yosemate/SpectrumLabPro-NIR-Kappa/docs/diagramas/amostras_ensaio_bancada.png

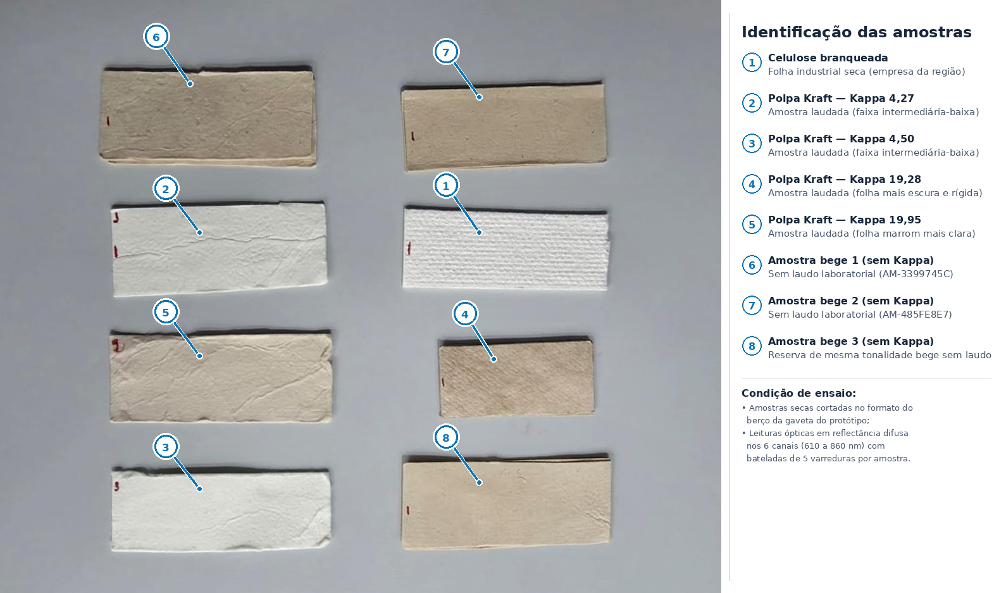
docs/diagramas/amostras_ensaio_bancada.png
