yosemate/SpectrumLabPro-NIR-Kappa/supervisorio/experiments/chemometrics/samples.csv

sample_id | position_id | reference_status | kappa | mode | source | r610 | r680 | r730 | r760 | r810 | r860
Celulose Branqueada | 1 | assumed | 0.58 | seco | Historico_Ensaios_20261104_134937.csv#AM-59970EEA | 0.895083515410534 | 0.8657941383580604 | 0.8793514544587505 | 0.8887390424814566 | 0.9374505146476644 | 0.8955890563930765
K4.27 | 1 | laboratory | 4.27 | seco | Historico_Ensaios_20261104_134937.csv#AM-E135CCEB | 0.9015022369484662 | 0.8992545467790107 | 0.8682244476235891 | 0.8808399961468067 | 0.9191267956113562 | 0.9262981574539364
K4.50 | 1 | laboratory | 4.5 | seco | Historico_Ensaios_20261104_134937.csv#AM-C46E7D0C | 0.7731278061898245 | 0.7919772721754121 | 0.7725321888412018 | 0.7742992004623832 | 0.7867888247935754 | 0.7995533221663874
K19.95 | 1 | laboratory | 19.95 | seco | Historico_Ensaios_20261104_134937.csv#AM-02C19AFC | 0.5799739089373894 | 0.6331253186994633 | 0.6561754887935146 | 0.6535015894422503 | 0.6123741658183462 | 0.6186487995533222
K19.28 | 1 | laboratory | 19.28 | seco | Historico_Ensaios_20261104_134937.csv#AM-88B14C31 | 0.39730445708980605 | 0.4741276740402593 | 0.48778678535473957 | 0.4876216164146036 | 0.43931681936432526 | 0.45728643216080406
K19.28 | 2 | laboratory | 19.28 | seco | AmostraKappa19.28Leitura2.pdf#AM-CECEA30A (PDF percent rounded to 0.01) | 0.4617 | 0.5431 | 0.5592 | 0.5593 | 0.5065 | 0.5254
K19.28 | 3 | laboratory | 19.28 | seco | AmostraKappa19.28Leitura3.pdf#AM-1658F269 (PDF percent rounded to 0.01) | 0.3367 | 0.3725 | 0.3829 | 0.3836 | 0.3751 | 0.38189999999999996
