yosemate/SpectrumLabPro-NIR-Kappa/supervisorio/experiments/chemometrics/samples_2sessoes_20261104.csv

sample_id | position_id | reference_status | kappa | mode | source | r610 | r680 | r730 | r760 | r810 | r860
Celulose Branqueada | cal1_pos1 | assumed | 0.58 | seco | Historico_Ensaios.csv#2 (13:29) | 0.895083515410534 | 0.8657941383580604 | 0.8793514544587505 | 0.8887390424814566 | 0.9374505146476644 | 0.8955890563930765
Celulose Branqueada | cal2_pos1 | assumed | 0.58 | seco | amostrabranqueada.json#AM-2372B3D5 (15:42) | 0.9197962871693774 | 0.8533909244365009 | 0.9187376292060699 | 0.8803196803196803 | 0.896184971098266 | 0.8724794092587332
K4.27 | cal1_pos1 | laboratory | 4.27 | seco | Historico_Ensaios.csv#5 (13:40) | 0.9015022369484662 | 0.8992545467790107 | 0.8682244476235891 | 0.8808399961468067 | 0.9191267956113562 | 0.9262981574539364
K4.27 | cal2_pos1 | laboratory | 4.27 | seco | amostra4.27.json#AM-16186A6A (15:32) | 0.9423196977164449 | 0.9504021447721179 | 0.9142291620848911 | 0.9300699300699301 | 0.9632369942196533 | 0.9775631922749218
K4.50 | cal1_pos1 | laboratory | 4.5 | seco | Historico_Ensaios.csv#4 (13:37) | 0.7731278061898245 | 0.7919772721754121 | 0.7725321888412018 | 0.7742992004623832 | 0.7867888247935754 | 0.7995533221663874
K4.50 | cal2_rep1 | laboratory | 4.5 | seco | Historico_Ensaios.csv#12 (15:23) | 0.8328733366190241 | 0.858107437195909 | 0.848031669232461 | 0.8659340659340659 | 0.8411560693641619 | 0.8588469184890654
K4.50 | cal2_rep2 | laboratory | 4.5 | seco | comparewacao_pls.json#AM-2EE02E57 (15:26) | 0.8323969114506325 | 0.8561711845894151 | 0.8478117440070376 | 0.8621378621378621 | 0.8397687861271677 | 0.8588469184890655
K19.95 | cal1_pos1 | laboratory | 19.95 | seco | Historico_Ensaios.csv#7 (13:46) | 0.5799739089373894 | 0.6331253186994633 | 0.6561754887935146 | 0.6535015894422503 | 0.6123741658183462 | 0.6186487995533222
K19.95 | cal2_pos1 | laboratory | 19.95 | seco | comparacao_pls.json#AM-4E4E2C73 (15:16) | 0.5921964843108263 | 0.6312679972197398 | 0.6645040686166703 | 0.6623376623376623 | 0.6196531791907515 | 0.6163021868787276
K19.28 | cal1_pos1 | laboratory | 19.28 | seco | Historico_Ensaios.csv#6 (13:44) | 0.39730445708980605 | 0.4741276740402593 | 0.48778678535473957 | 0.4876216164146036 | 0.43931681936432526 | 0.45728643216080406
K19.28 | cal1_pos2 | laboratory | 19.28 | seco | Historico_Ensaios.csv#8 (13:54) | 0.46171576748541376 | 0.543136731175485 | 0.5592115720871086 | 0.5592910124265486 | 0.5065037891641218 | 0.5254048017867113
K19.28 | cal1_pos3 | laboratory | 19.28 | seco | Historico_Ensaios.csv#9 (13:59) | 0.3366867551841981 | 0.3724837918558628 | 0.3828750066232184 | 0.3835853963972642 | 0.3750706933604796 | 0.3819095477386935
K19.28 | cal2_pos1 | laboratory | 19.28 | seco | Historico_Ensaios.csv#10 (15:13) | 0.3856743880400854 | 0.45303346241684045 | 0.4776775896195294 | 0.48031968031968036 | 0.4249710982658959 | 0.437943765975575
