yosemate/SpectrumLabPro-NIR-Kappa/supervisorio/requirements-experimental.txt

# Training only. JSON coefficient inference requires only existing NumPy.
scikit-learn==1.9.1
