yosemate/SpectrumLabPro-NIR-Kappa/supervisorio/main.py

"""
SPECTRUM-LAB PRO (v3.1 Fluent Edition)
Sistema Supervisório e Analisador Espectrométrico NIR/VIS (GY-AS7263)
Metodologia Quimiométrica: Suspensão Aquosa de Celulose sob Lâmina e Lamínula.

Funcionalidades Consolidadas:
1. Protocolo Serial Consolidado (115200 Baud):
   - Comandos de Saída (\\n): CMD:PING, CMD:ABRIR_GAVETA, CMD:FECHAR_GAVETA,
     CMD:AVANCAR_SENSOR, CMD:RECUAR_SENSOR, CMD:LER_ESPECTRO, CMD:EMERGENCIA.
   - Telemetrias de Retorno: STATUS:SENSOR_OK / STATUS:PRONTO, STATUS:PONG,
     STATUS:GAVETA_ABERTA, STATUS:GAVETA_FECHADA, STATUS:SENSOR_AVANCADO,
     STATUS:SENSOR_RECUADO, DATA:v1..v6, STATUS:LEITURA_CONCLUIDA, STATUS:EMERGENCIA_ACIONADA.
2. Desacoplamento Atômico dos Controles Manuais (intertravamento até retorno do STATUS).
3. Ciclos Automáticos da Máquina de Estados (FSM):
   - Ciclo Automático Simples (Fechar Gaveta -> Avançar -> Ler -> Recuar -> Abrir).
   - Teste de Repetibilidade (Posicionamento Único, 5 Leituras 100% Estáticas, estatísticas u, s, CV%).
   - Parada de Emergência (E-Stop prioritário imediato e restauração segura).
4. Camada de Calibração e Quimiometria:
   - Persistência em calibracao.json (Branco com Água Destilada e Escuro).
   - Refletância Relativa (R_i) e Normalização Vetorial SNV (R_norm).
   - Eixos do Gráfico 2D: X (Celulose R680/R730) vs Y (Água R860/R760).
5. Auditoria e Isolamento de Threads com SerialWorker sem duplicações de sinal.
"""

import sys
import os
import json
import csv
import datetime
import random
import math
import tempfile
import traceback
import uuid
import time
from typing import Optional, List, Dict

from PyQt5.QtWidgets import (
    QApplication, QMainWindow, QWidget, QVBoxLayout, QHBoxLayout, QGridLayout, QLabel,
    QPushButton, QComboBox, QProgressBar, QFrame, QTextEdit, QMessageBox,
    QInputDialog, QLineEdit, QFileDialog, QSplitter, QStackedWidget, QDialog,
    QTableWidget, QTableWidgetItem, QHeaderView, QTabWidget, QMenuBar, QMenu, QAction,
    QSizePolicy, QAbstractItemView, QProgressDialog
)
from PyQt5.QtCore import Qt, QTimer, QThread, QEventLoop, QCoreApplication, QUrl
from PyQt5.QtGui import QFont, QColor, QDesktopServices, QGuiApplication


def open_local_document(path):
    if not QDesktopServices.openUrl(QUrl.fromLocalFile(os.path.abspath(path))):
        raise OSError("Não foi possível abrir o leitor padrão de PDF.")

# Ativação antecipada de suporte nativo a High-DPI para telas de notebook com escala 125%/150%
try:
    if hasattr(QGuiApplication, "setHighDpiScaleFactorRoundingPolicy"):
        QGuiApplication.setHighDpiScaleFactorRoundingPolicy(
            Qt.HighDpiScaleFactorRoundingPolicy.PassThrough
        )
    QCoreApplication.setAttribute(Qt.AA_EnableHighDpiScaling, True)
    QCoreApplication.setAttribute(Qt.AA_UseHighDpiPixmaps, True)
except Exception:
    pass

# Matplotlib para integração gráfica Qt
from matplotlib.backends.backend_qt5agg import FigureCanvasQTAgg as FigureCanvas
from matplotlib.figure import Figure
import matplotlib.pyplot as plt

# Módulos locais
from responsive_layout import ScaledCanvasView, DialogScreenAdapter
from appearance import ensure_theme_manager, AppearanceDialog
from popup_design import WarningSymbol, AnimatedOperationBar, OperatingAlertDialog
from splash_screen import AnimatedSplashScreen
from animated_chart import SpectralSplineChartWidget, ScatterPlotWidget
from database_manager import DatabaseManagerDialog
from chemometrics import classify_experimental_kappa
from pdf_generator import generate_pdf_report
from batch_reports import BatchExportDialog, PdfBatchWorker
from connection_worker import ConnectionWorker
from serial_worker import SerialWorker
from chemometrics import (
    ChemometricsEngine, calculate_hybrid_similarity, calculate_kappa_number,
    WAVELENGTHS, CHANNEL_NAMES, OPERATIONAL_MODES, MODE_LABELS,
    CALIB_TIMEOUT_OPTIONS, DEFAULT_TIMEOUT_SECS
)
from manual_control_dialog import ManualControlDialog
from equipment_interlocks import EquipmentInterlocks
from database import get_database_path, DatabaseManager
from runtime_data import prepare_data_files
from auth_manager import AuthManager
from auth_dialogs import DialogLogin, DialogGestaoUsuarios
from brand_assets import application_icon
from version import __version__, __build__, __app_name__, __app_title__, __app_full_title__


# =====================================================================
# 0. DIÁLOGO MODAL DE CALIBRAÇÃO EXPIRADA (INTERTRAVAMENTO METROLÓGICO)
# =====================================================================
class CalibrationExpiredDialog(QDialog):
    """
    Diálogo modal de advertência e intertravamento metrológico disparado
    quando o tempo de validade da calibração do método operacional ativo é atingido.
    """
    def __init__(self, parent=None, active_mode="umido"):
        super().__init__(parent)
        self.setWindowTitle("⚠️ Alerta Metrológico — Calibração Expirada")
        self.setFixedSize(540, 260)
        self.setStyleSheet("""
            QDialog {
                background-color: #18181B;
                border: 2px solid #EF4444;
                border-radius: 12px;
            }
            QLabel {
                color: #F3F4F6;
                font-family: 'Segoe UI', Arial, sans-serif;
            }
        """)

        layout = QVBoxLayout(self)
        layout.setContentsMargins(24, 20, 24, 20)
        layout.setSpacing(14)

        header_layout = QHBoxLayout()
        icon = QLabel("🛑")
        icon.setStyleSheet("font-size: 32px;")
        header_layout.addWidget(icon)

        title_box = QVBoxLayout()
        title = QLabel("CALIBRAÇÃO INSTRUMENTAL EXPIRADA")
        title.setStyleSheet("color: #EF4444; font-size: 14px; font-weight: 800; letter-spacing: 0.5px;")
        mode_label = MODE_LABELS.get(active_mode, active_mode)
        sub = QLabel(f"Método Analítico: <b>{mode_label}</b>")
        sub.setStyleSheet("color: #38BDF8; font-size: 11px;")
        title_box.addWidget(title)
        title_box.addWidget(sub)
        header_layout.addLayout(title_box)
        header_layout.addStretch()
        layout.addLayout(header_layout)

        msg = QLabel(
            "O intervalo de validade metrológica desta calibração foi atingido.<br>"
            "Para assegurar a repetibilidade e a exatidão analítica de celulose e lignina, "
            "as rotinas de ciclo automático e repetibilidade foram <b>intertravadas</b> preventivamente.<br><br>"
            "Deseja realizar a calibração de referência agora?"
        )
        msg.setStyleSheet("color: #D1D5DB; font-size: 11px; line-height: 1.4;")
        msg.setWordWrap(True)
        layout.addWidget(msg)

        btn_layout = QHBoxLayout()
        btn_layout.addStretch()

        self.btn_cancel = QPushButton("Fechar")
        self.btn_cancel.setStyleSheet("""
            QPushButton {
                background-color: #27272A;
                color: #A1A1AA;
                border: 1px solid #3F3F46;
                padding: 8px 16px;
                border-radius: 6px;
                font-weight: bold;
                font-size: 11px;
            }
            QPushButton:hover {
                background-color: #3F3F46;
                color: #FFFFFF;
            }
        """)
        self.btn_cancel.clicked.connect(self.reject)
        btn_layout.addWidget(self.btn_cancel)

        self.btn_calib = QPushButton("🎯 Calibrar Agora")
        self.btn_calib.setStyleSheet("""
            QPushButton {
                background-color: #0284C7;
                color: #FFFFFF;
                border: none;
                padding: 8px 20px;
                border-radius: 6px;
                font-weight: bold;
                font-size: 11px;
            }
            QPushButton:hover {
                background-color: #0369A1;
            }
        """)
        self.btn_calib.clicked.connect(self.accept)
        btn_layout.addWidget(self.btn_calib)

        layout.addLayout(btn_layout)


# =====================================================================
# 0.1 DIÁLOGO MODAL DE HISTÓRICO COMPLETO DE ENSAIOS (FLUENT DESIGN)
# =====================================================================
class HistoryDialog(QDialog):
    """
    Diálogo modal com Fluent Design (~1050x700 px) para consulta, visualização,
    geração de laudos PDF sob demanda, exclusão física e exportação CSV
    de todos os ensaios espectrais persistidos no SQLite (tabela leituras_historico).
    """
    def __init__(self, db_manager: DatabaseManager, parent=None):
        super().__init__(parent)
        self.db_manager = db_manager
        self.leituras = []
        self.current_selected = None
        self._batch_worker = None
        self._batch_result = None

        self.setWindowTitle("📋 Histórico Completo de Ensaios Espectrais — SPECTRUM-LAB PRO")
        self.resize(1080, 720)
        self.setMinimumSize(960, 640)
        self.setStyleSheet("""
            QDialog {
                background-color: #18181B;
                color: #FFFFFF;
                font-family: 'Segoe UI', Arial, sans-serif;
            }
            QLabel {
                color: #FFFFFF;
            }
            QLineEdit {
                background-color: #27272A;
                color: #FFFFFF;
                border: 1px solid #3F3F46;
                border-radius: 6px;
                padding: 6px 10px;
                font-size: 11px;
            }
            QLineEdit:focus {
                border: 1px solid #0284C7;
            }
            QTableWidget {
                background-color: #202023;
                color: #F4F4F5;
                border: 1px solid #3F3F46;
                border-radius: 6px;
                gridline-color: #2E2E33;
                selection-background-color: #0284C7;
                selection-color: #FFFFFF;
                font-size: 11px;
            }
            QHeaderView::section {
                background-color: #27272A;
                color: #A1A1AA;
                border: none;
                border-bottom: 1px solid #3F3F46;
                padding: 5px;
                font-weight: bold;
                font-size: 10px;
            }
            QPushButton {
                background-color: #27272A;
                color: #FFFFFF;
                border: 1px solid #3F3F46;
                border-radius: 6px;
                padding: 7px 14px;
                font-size: 11px;
                font-weight: bold;
            }
            QPushButton:hover {
                background-color: #3F3F46;
            }
            QPushButton:disabled {
                background-color: #1F1F22;
                color: #71717A;
                border-color: #2E2E33;
            }
        """)

        self._init_ui()
        self._carregar_leituras()

    def _init_ui(self):
        main_layout = QVBoxLayout(self)
        main_layout.setContentsMargins(18, 16, 18, 16)
        main_layout.setSpacing(12)

        # Cabeçalho do diálogo
        head_layout = QHBoxLayout()
        icon = QLabel("📋")
        icon.setStyleSheet("font-size: 24px;")
        head_layout.addWidget(icon)

        title_box = QVBoxLayout()
        dlg_title = QLabel("HISTÓRICO DE ENSAIOS ESPECTRAIS")
        dlg_title.setStyleSheet("color: #FFFFFF; font-size: 15px; font-weight: 800; letter-spacing: 0.5px;")
        dlg_sub = QLabel("Consulta metrológica, emissão de relatórios experimentais PDF e auditoria de leituras")
        dlg_sub.setStyleSheet("color: #9CA3AF; font-size: 11px;")
        title_box.addWidget(dlg_title)
        title_box.addWidget(dlg_sub)
        head_layout.addLayout(title_box)
        head_layout.addStretch()

        self.btn_fechar = QPushButton("✕ Fechar")
        self.btn_fechar.clicked.connect(self.accept)
        head_layout.addWidget(self.btn_fechar)
        main_layout.addLayout(head_layout)

        # Divisor horizontal central
        splitter = QSplitter(Qt.Horizontal)
        splitter.setHandleWidth(2)
        splitter.setStyleSheet("QSplitter::handle { background-color: #333338; }")

        # --- Painel Esquerdo: Busca e Tabela ---
        left_widget = QWidget()
        left_layout = QVBoxLayout(left_widget)
        left_layout.setContentsMargins(0, 0, 8, 0)
        left_layout.setSpacing(8)

        self.txt_busca = QLineEdit()
        self.txt_busca.setPlaceholderText("🔍 Buscar por código de amostra, operador, data...")
        self.txt_busca.textChanged.connect(self._on_search_changed)
        search_actions = QHBoxLayout()
        search_actions.addWidget(self.txt_busca, 1)
        self.btn_batch_pdf = QPushButton("Exportar PDFs em lote")
        self.btn_batch_pdf.setMinimumHeight(34)
        self.btn_batch_pdf.clicked.connect(self._on_exportar_pdf_lote)
        search_actions.addWidget(self.btn_batch_pdf)
        left_layout.addLayout(search_actions)

        self.table = QTableWidget()
        self.table.setColumnCount(6)
        self.table.setHorizontalHeaderLabels(["ID", "Data / Hora", "Amostra", "Método", "Kappa", "ADC Global"])
        self.table.setSelectionBehavior(QAbstractItemView.SelectRows)
        self.table.setSelectionMode(QAbstractItemView.ExtendedSelection)
        self.table.setToolTip("Use Ctrl ou Shift para selecionar vários ensaios; Ctrl+A seleciona todos.")
        self.table.setEditTriggers(QAbstractItemView.NoEditTriggers)
        self.table.verticalHeader().setVisible(False)
        self.table.horizontalHeader().setStretchLastSection(True)
        self.table.setColumnWidth(0, 45)
        self.table.setColumnWidth(1, 125)
        self.table.setColumnWidth(2, 95)
        self.table.setColumnWidth(3, 85)
        self.table.setColumnWidth(4, 55)
        self.table.itemSelectionChanged.connect(self._on_selection_changed)
        left_layout.addWidget(self.table)

        self.lbl_total_records = QLabel("Total: 0 ensaios")
        self.lbl_total_records.setStyleSheet("color: #71717A; font-size: 10px;")
        left_layout.addWidget(self.lbl_total_records)
        splitter.addWidget(left_widget)

        # --- Painel Direito: Preview e Ações ---
        right_widget = QWidget()
        right_layout = QVBoxLayout(right_widget)
        right_layout.setContentsMargins(8, 0, 0, 0)
        right_layout.setSpacing(10)

        # Card de Detalhes da Leitura
        self.preview_card = QFrame()
        self.preview_card.setStyleSheet("background-color: #202023; border: 1px solid #3F3F46; border-radius: 8px;")
        card_layout = QVBoxLayout(self.preview_card)
        card_layout.setContentsMargins(14, 12, 14, 12)
        card_layout.setSpacing(10)

        # Título da Leitura Selecionada
        self.lbl_preview_title = QLabel("Selecione um ensaio na lista à esquerda")
        self.lbl_preview_title.setStyleSheet("color: #F4F4F5; font-size: 13px; font-weight: bold;")
        self.lbl_preview_meta = QLabel("Nenhum registro selecionado.")
        self.lbl_preview_meta.setStyleSheet("color: #A1A1AA; font-size: 10px;")
        card_layout.addWidget(self.lbl_preview_title)
        card_layout.addWidget(self.lbl_preview_meta)

        # 3 Cards de KPI em linha
        kpis_layout = QHBoxLayout()
        kpis_layout.setSpacing(8)

        # KPI 1: Kappa
        self.card_kpi_kappa = QFrame()
        self.card_kpi_kappa.setStyleSheet("background-color: #27272A; border: 1px solid #3F3F46; border-radius: 6px;")
        kpi_k_layout = QVBoxLayout(self.card_kpi_kappa)
        kpi_k_layout.setContentsMargins(8, 6, 8, 6)
        kpi_k_layout.setSpacing(2)
        lbl_k_head = QLabel("KAPPA DEMONSTRATIVO")
        lbl_k_head.setStyleSheet("color: #A1A1AA; font-size: 9px; font-weight: bold;")
        self.lbl_k_val = QLabel("--")
        self.lbl_k_val.setStyleSheet("color: #C084FC; font-size: 16px; font-weight: 900;")
        self.lbl_k_badge = QLabel("Aguardando")
        self.lbl_k_badge.setStyleSheet("color: #71717A; font-size: 9px; font-weight: bold;")
        kpi_k_layout.addWidget(lbl_k_head)
        kpi_k_layout.addWidget(self.lbl_k_val)
        kpi_k_layout.addWidget(self.lbl_k_badge)
        kpis_layout.addWidget(self.card_kpi_kappa)

        # KPI 2: Energia / Pico
        self.card_kpi_peak = QFrame()
        self.card_kpi_peak.setStyleSheet("background-color: #27272A; border: 1px solid #3F3F46; border-radius: 6px;")
        kpi_p_layout = QVBoxLayout(self.card_kpi_peak)
        kpi_p_layout.setContentsMargins(8, 6, 8, 6)
        kpi_p_layout.setSpacing(2)
        lbl_p_head = QLabel("PICO DOMINANTE")
        lbl_p_head.setStyleSheet("color: #A1A1AA; font-size: 9px; font-weight: bold;")
        self.lbl_p_val = QLabel("--")
        self.lbl_p_val.setStyleSheet("color: #60A5FA; font-size: 16px; font-weight: 900;")
        self.lbl_p_sub = QLabel("ADC Total: --")
        self.lbl_p_sub.setStyleSheet("color: #71717A; font-size: 9px;")
        kpi_p_layout.addWidget(lbl_p_head)
        kpi_p_layout.addWidget(self.lbl_p_val)
        kpi_p_layout.addWidget(self.lbl_p_sub)
        kpis_layout.addWidget(self.card_kpi_peak)

        # KPI 3: Razões Ópticas
        self.card_kpi_ratios = QFrame()
        self.card_kpi_ratios.setStyleSheet("background-color: #27272A; border: 1px solid #3F3F46; border-radius: 6px;")
        kpi_r_layout = QVBoxLayout(self.card_kpi_ratios)
        kpi_r_layout.setContentsMargins(8, 6, 8, 6)
        kpi_r_layout.setSpacing(2)
        lbl_r_head = QLabel("RAZÕES ÓPTICAS")
        lbl_r_head.setStyleSheet("color: #A1A1AA; font-size: 9px; font-weight: bold;")
        self.lbl_r_cel = QLabel("Celulose (680/730): --")
        self.lbl_r_cel.setStyleSheet("color: #10B981; font-size: 11px; font-weight: bold;")
        self.lbl_r_wat = QLabel("Matriz (860/760): --")
        self.lbl_r_wat.setStyleSheet("color: #38BDF8; font-size: 11px; font-weight: bold;")
        kpi_r_layout.addWidget(lbl_r_head)
        kpi_r_layout.addWidget(self.lbl_r_cel)
        kpi_r_layout.addWidget(self.lbl_r_wat)
        kpis_layout.addWidget(self.card_kpi_ratios)

        card_layout.addLayout(kpis_layout)

        # Tabela Multicanal da Leitura Selecionada
        lbl_tbl_title = QLabel("DISCRIMINAÇÃO ESPECTRAL DAS 6 BANDAS")
        lbl_tbl_title.setStyleSheet("color: #A1A1AA; font-size: 9px; font-weight: bold; letter-spacing: 0.5px; margin-top: 4px;")
        card_layout.addWidget(lbl_tbl_title)

        self.table_channels = QTableWidget(6, 4)
        self.table_channels.setHorizontalHeaderLabels(["Canal", "λ (nm)", "ADC Bruto", "Refletância (%)"])
        self.table_channels.verticalHeader().setVisible(False)
        self.table_channels.horizontalHeader().setStretchLastSection(True)
        self.table_channels.setEditTriggers(QAbstractItemView.NoEditTriggers)
        self.table_channels.setFixedHeight(175)
        card_layout.addWidget(self.table_channels)

        right_layout.addWidget(self.preview_card)

        # Barra de Ações Rápidas
        actions_box = QHBoxLayout()
        actions_box.setSpacing(8)

        self.btn_view_pdf = QPushButton("📄 Visualizar Relatório PDF")
        self.btn_view_pdf.setStyleSheet("background-color: #0284C7; color: #FFFFFF; border: none;")
        self.btn_view_pdf.clicked.connect(self._on_visualizar_pdf)
        self.btn_view_pdf.setEnabled(False)

        self.btn_save_pdf = QPushButton("💾 Salvar Relatório Como...")
        self.btn_save_pdf.clicked.connect(self._on_salvar_pdf)
        self.btn_save_pdf.setEnabled(False)

        self.btn_delete = QPushButton("🗑 Excluir Registro")
        self.btn_delete.setStyleSheet("background-color: #7F1D1D; color: #F87171; border: 1px solid #991B1B;")
        self.btn_delete.clicked.connect(self._on_excluir_registro)
        self.btn_delete.setEnabled(False)

        self.btn_export_csv = QPushButton("📥 Exportar CSV")
        self.btn_export_csv.clicked.connect(self._on_exportar_csv)

        actions_box.addWidget(self.btn_view_pdf)
        actions_box.addWidget(self.btn_save_pdf)
        actions_box.addWidget(self.btn_delete)
        actions_box.addWidget(self.btn_export_csv)
        right_layout.addLayout(actions_box)

        splitter.addWidget(right_widget)
        splitter.setSizes([480, 560])
        main_layout.addWidget(splitter, stretch=1)

    def _carregar_leituras(self, filtro=None):
        self.leituras = self.db_manager.listar_leituras(filtro)
        self.table.setRowCount(len(self.leituras))
        for row_idx, item in enumerate(self.leituras):
            id_str = str(item.get("id", ""))
            ts_str = str(item.get("timestamp", ""))
            amostra_str = str(item.get("codigo_amostra", ""))
            is_seco = "sec" in str(item.get("metodo_analitico", "")).lower()
            metodo_str = "Seco" if is_seco else "Úmido"
            kappa_val = item.get("kappa_estimado", 0.0)
            kappa_str = f"{kappa_val:.2f}"
            adc_str = f"{int(item.get('intensidade_global_adc', 0)):,}".replace(",", ".")

            self.table.setItem(row_idx, 0, QTableWidgetItem(id_str))
            self.table.setItem(row_idx, 1, QTableWidgetItem(ts_str))
            self.table.setItem(row_idx, 2, QTableWidgetItem(amostra_str))
            self.table.setItem(row_idx, 3, QTableWidgetItem(metodo_str))
            
            it_kappa = QTableWidgetItem(kappa_str)
            it_kappa.setForeground(QColor("#C084FC" if kappa_val < 15.0 else "#F59E0B"))
            self.table.setItem(row_idx, 4, it_kappa)
            
            self.table.setItem(row_idx, 5, QTableWidgetItem(adc_str))

        self.lbl_total_records.setText(f"Total: {len(self.leituras)} ensaios registrados")
        if not self.leituras:
            self._limpar_preview()

    def _on_search_changed(self, text):
        self._carregar_leituras(text.strip())

    def _limpar_preview(self):
        self.current_selected = None
        self.lbl_preview_title.setText("Selecione um ensaio na lista à esquerda")
        self.lbl_preview_meta.setText("Nenhum registro selecionado.")
        self.lbl_k_val.setText("--")
        self.lbl_k_badge.setText("Aguardando")
        self.lbl_p_val.setText("--")
        self.lbl_p_sub.setText("ADC Total: --")
        self.lbl_r_cel.setText("Celulose (680/730): --")
        self.lbl_r_wat.setText("Matriz (860/760): --")
        self.table_channels.clearContents()
        self.btn_view_pdf.setEnabled(False)
        self.btn_save_pdf.setEnabled(False)
        self.btn_delete.setEnabled(False)

    def _on_selection_changed(self):
        selected_rows = self.table.selectionModel().selectedRows()
        if not selected_rows:
            self._limpar_preview()
            return
        row_idx = selected_rows[0].row()
        if row_idx >= len(self.leituras):
            return

        item = self.leituras[row_idx]
        self.current_selected = item

        # Atualiza Header
        cod = item.get("codigo_amostra", "AM-0001")
        ts = item.get("timestamp", "")
        op = item.get("operador", "Operador")
        met = item.get("metodo_analitico", "Modo Seco")
        self.lbl_preview_title.setText(f"Amostra: {cod} (ID #{item['id']})")
        self.lbl_preview_meta.setText(f"Data: {ts} | Operador: {op} | Método: {met}")

        # KPI 1: Kappa
        kappa_val = item.get("kappa_estimado", 0.0)
        self.lbl_k_val.setText(f"{kappa_val:.2f}")
        status_txt = classify_experimental_kappa(kappa_val)[0]
        self.lbl_k_badge.setText(status_txt)

        badge_col = classify_experimental_kappa(kappa_val)[1]

        self.lbl_k_badge.setStyleSheet(f"color: {badge_col}; font-size: 9px; font-weight: bold;")

        # KPI 2: Pico / ADC
        pico_nm = item.get("pico_espectral_nm", 610)
        pico_adc = item.get("pico_espectral_adc", 0)
        total_adc = item.get("intensidade_global_adc", 0)
        self.lbl_p_val.setText(f"{pico_nm} nm")
        self.lbl_p_sub.setText(f"Pico: {pico_adc:,} ADC | Total: {total_adc:,} ADC".replace(",", "."))

        # KPI 3: Razões
        r_c = item.get("razao_celulose", 0.0)
        r_w = item.get("razao_agua", 0.0)
        self.lbl_r_cel.setText(f"Celulose (680/730): {r_c:.2f}")
        self.lbl_r_wat.setText(f"Matriz (860/760): {r_w:.2f}")

        # Tabela Multicanal
        wls = [610, 680, 730, 760, 810, 860]
        cnames = ['Vermelho', 'Vermelho Profundo', 'NIR 730', 'NIR 760', 'NIR 810', 'NIR 860']
        adcs = [
            item.get("adc_610", 0.0), item.get("adc_680", 0.0), item.get("adc_730", 0.0),
            item.get("adc_760", 0.0), item.get("adc_810", 0.0), item.get("adc_860", 0.0)
        ]
        refs = [
            item.get("ref_610", 0.0), item.get("ref_680", 0.0), item.get("ref_730", 0.0),
            item.get("ref_760", 0.0), item.get("ref_810", 0.0), item.get("ref_860", 0.0)
        ]
        for i in range(6):
            self.table_channels.setItem(i, 0, QTableWidgetItem(cnames[i]))
            self.table_channels.setItem(i, 1, QTableWidgetItem(f"{wls[i]} nm"))
            self.table_channels.setItem(i, 2, QTableWidgetItem(f"{int(adcs[i]):,} ADC".replace(",", ".")))
            self.table_channels.setItem(i, 3, QTableWidgetItem(f"{refs[i]:.2f}%"))

        single = len(selected_rows) == 1
        self.btn_view_pdf.setEnabled(single)
        self.btn_save_pdf.setEnabled(single)
        self.btn_delete.setEnabled(single)

    def _on_exportar_pdf_lote(self):
        if self._batch_worker is not None and self._batch_worker.isRunning():
            return
        selected_ids = [self.leituras[index.row()]['id']
                        for index in self.table.selectionModel().selectedRows()
                        if index.row() < len(self.leituras)]
        dialog = BatchExportDialog(self.db_manager.listar_leituras(), selected_ids, self)
        if dialog.exec_() != QDialog.Accepted:
            return
        directory = QFileDialog.getExistingDirectory(self, "Escolha a pasta para os laudos")
        if not directory:
            return
        records = dialog.filtered_records
        self._batch_result = None
        self._batch_progress = QProgressDialog("Gerando laudos PDF...", "Cancelar", 0, len(records), self)
        self._batch_progress.setWindowTitle("Exportação de laudos")
        self._batch_progress.setMinimumDuration(0)
        self._batch_progress.setAutoClose(False)
        self._batch_worker = PdfBatchWorker(records, directory, self)
        self._batch_worker.progress.connect(self._batch_progress.setValue)
        self._batch_worker.completed.connect(self._receive_batch_result)
        self._batch_worker.finished.connect(self._finish_batch_export)
        self._batch_progress.canceled.connect(self._batch_worker.requestInterruption)
        self.btn_batch_pdf.setEnabled(False)
        self._batch_progress.show()
        self._batch_worker.start()

    def _receive_batch_result(self, result):
        self._batch_result = result

    def _finish_batch_export(self):
        self._batch_progress.close()
        self._batch_progress.deleteLater()
        self.btn_batch_pdf.setEnabled(True)
        worker = self._batch_worker
        self._batch_worker = None
        worker.deleteLater()
        result = self._batch_result or {'files': [], 'errors': ['Exportação interrompida.'], 'folder': '', 'cancelled': True}
        message = QMessageBox(self)
        message.setWindowTitle("Exportação de laudos PDF")
        message.setIcon(QMessageBox.Warning if result['errors'] else QMessageBox.Information)
        message.setText(("Exportação cancelada." if result['cancelled'] else "Exportação concluída.") +
                        f"\n{len(result['files'])} PDF(s) gerado(s); {len(result['errors'])} falha(s).\n\nPasta:\n{result['folder']}")
        if result['errors']:
            message.setDetailedText('\n'.join(result['errors']))
        message.exec_()

    def reject(self):
        if self._batch_worker is not None and self._batch_worker.isRunning():
            self._batch_worker.requestInterruption()
            return
        super().reject()

    def closeEvent(self, event):
        if self._batch_worker is not None and self._batch_worker.isRunning():
            self._batch_worker.requestInterruption()
            event.ignore()
            return
        super().closeEvent(event)

    def _on_visualizar_pdf(self):
        try:
            if not self.current_selected:
                return
            item = self.current_selected
            unique_id = f"{item.get('id', 0)}_{datetime.datetime.now().strftime('%Y%m%d_%H%M%S_%f')}"
            temp_dir = tempfile.gettempdir()
            pdf_path = os.path.join(temp_dir, f"Relatorio_Preview_{item.get('codigo_amostra', 'AM')}_{unique_id}.pdf")

            generate_pdf_report(
                filename=pdf_path,
                sample_id=item.get("codigo_amostra", "AM-0001"),
                operator=item.get("operador", "Operador"),
                kappa_value=item.get("kappa_estimado", 0.0),
                operational_mode="seco" if "sec" in str(item.get("metodo_analitico", "")).lower() else "umido",
                kappa_status=item.get("kappa_classificacao"),
                calibration_snapshot=json.loads(item["calibration_snapshot"]) if item.get("calibration_snapshot") else None,
                acquisition_count=item.get("acquisition_count") or 0,
                raw_scans=json.loads(item["raw_scans_json"]) if item.get("raw_scans_json") else None,
                values=[
                    item.get("ref_610", 0.0), item.get("ref_680", 0.0), item.get("ref_730", 0.0),
                    item.get("ref_760", 0.0), item.get("ref_810", 0.0), item.get("ref_860", 0.0)
                ],
                raw_adc_values=[
                    item.get("adc_610", 0.0), item.get("adc_680", 0.0), item.get("adc_730", 0.0),
                    item.get("adc_760", 0.0), item.get("adc_810", 0.0), item.get("adc_860", 0.0)
                ],
                ratio_celulose=item.get("razao_celulose"),
                ratio_agua=item.get("razao_agua"),
                global_intensity_adc=item.get("intensidade_global_adc"),
                peak_wavelength_nm=item.get("pico_espectral_nm"),
                peak_intensity_adc=item.get("pico_espectral_adc"),
                timestamp=item.get("timestamp")
            )
            try:
                open_local_document(pdf_path)
            except Exception as start_err:
                QMessageBox.warning(
                    self, "Aviso de Visualização",
                    f"O Relatório Experimental PDF foi gerado com sucesso em:\n{pdf_path}\n\n"
                    f"Porém não foi possível abrir o leitor padrão do sistema: {start_err}"
                )
        except Exception as e:
            traceback.print_exc()
            QMessageBox.critical(self, "Erro ao Gerar PDF", f"Não foi possível gerar o Relatório Experimental PDF:\n{e}")

    def _on_salvar_pdf(self):
        if not self.current_selected:
            return
        item = self.current_selected
        def_name = f"Relatorio_{item.get('codigo_amostra', 'AM')}_{datetime.datetime.now().strftime('%Y%m%d_%H%M%S')}.pdf"
        file_path, _ = QFileDialog.getSaveFileName(self, "Salvar Relatório Experimental PDF", def_name, "Arquivos PDF (*.pdf)")
        if file_path:
            try:
                generate_pdf_report(
                    filename=file_path,
                    sample_id=item.get("codigo_amostra", "AM-0001"),
                    operator=item.get("operador", "Operador"),
                    kappa_value=item.get("kappa_estimado", 0.0),
                    operational_mode="seco" if "sec" in str(item.get("metodo_analitico", "")).lower() else "umido",
                    kappa_status=item.get("kappa_classificacao"),
                calibration_snapshot=json.loads(item["calibration_snapshot"]) if item.get("calibration_snapshot") else None,
                acquisition_count=item.get("acquisition_count") or 0,
                raw_scans=json.loads(item["raw_scans_json"]) if item.get("raw_scans_json") else None,
                    values=[
                        item.get("ref_610", 0.0), item.get("ref_680", 0.0), item.get("ref_730", 0.0),
                        item.get("ref_760", 0.0), item.get("ref_810", 0.0), item.get("ref_860", 0.0)
                    ],
                    raw_adc_values=[
                        item.get("adc_610", 0.0), item.get("adc_680", 0.0), item.get("adc_730", 0.0),
                        item.get("adc_760", 0.0), item.get("adc_810", 0.0), item.get("adc_860", 0.0)
                    ],
                    ratio_celulose=item.get("razao_celulose"),
                    ratio_agua=item.get("razao_agua"),
                    global_intensity_adc=item.get("intensidade_global_adc"),
                    peak_wavelength_nm=item.get("pico_espectral_nm"),
                    peak_intensity_adc=item.get("pico_espectral_adc"),
                    timestamp=item.get("timestamp")
                )
                QMessageBox.information(self, "Sucesso", f"Relatório salvo com sucesso em:\n{file_path}")
            except PermissionError:
                QMessageBox.warning(
                    self, "Arquivo Bloqueado",
                    f"Não foi possível salvar o relatório em:\n{file_path}\n\n"
                    "O arquivo está aberto e bloqueado por outro aplicativo.\n"
                    "Feche o visualizador de PDF ou escolha outro nome de arquivo."
                )
            except Exception as e:
                QMessageBox.critical(self, "Erro", f"Erro ao salvar PDF: {e}")

    def _on_excluir_registro(self):
        if not self.current_selected:
            return
        item = self.current_selected
        reply = QMessageBox.question(
            self, "Confirmar Exclusão",
            f"Deseja realmente excluir permanentemente o ensaio ID #{item['id']} da amostra '{item.get('codigo_amostra')}'?\nEsta ação não poderá ser desfeita.",
            QMessageBox.Yes | QMessageBox.No, QMessageBox.No
        )
        if reply == QMessageBox.Yes:
            ok = self.db_manager.excluir_leitura(item['id'])
            if ok:
                self.current_selected = None
                self._carregar_leituras(self.txt_busca.text())
                QMessageBox.information(self, "Sucesso", "Registro excluído com sucesso do banco de dados.")
            else:
                QMessageBox.warning(self, "Aviso", "Não foi possível excluir o registro.")

    def _on_exportar_csv(self):
        if not self.leituras:
            QMessageBox.warning(self, "Aviso", "Não há leituras disponíveis para exportação.")
            return
        def_name = f"Historico_Ensaios_{datetime.datetime.now().strftime('%Y%m%d_%H%M%S')}.csv"
        file_path, _ = QFileDialog.getSaveFileName(self, "Exportar Histórico CSV", def_name, "Arquivos CSV (*.csv)")
        if file_path:
            try:
                import csv
                with open(file_path, "w", newline="", encoding="utf-8-sig") as f:
                    writer = csv.writer(f, delimiter=";")
                    writer.writerow([
                        "ID", "Data_Hora", "Amostra", "Operador", "Metodo",
                        "Kappa_Demonstrativo", "Faixa_Modelo_Experimental",
                        "Intensidade_Global_ADC", "Pico_NM", "Pico_ADC",
                        "Razao_Celulose", "Razao_Agua",
                        "ADC_610", "ADC_680", "ADC_730", "ADC_760", "ADC_810", "ADC_860",
                        "Ref_610", "Ref_680", "Ref_730", "Ref_760", "Ref_810", "Ref_860"
                    ])
                    for row in self.leituras:
                        writer.writerow([
                            row.get("id"), row.get("timestamp"), row.get("codigo_amostra"), row.get("operador"), row.get("metodo_analitico"),
                            row.get("kappa_estimado"), row.get("kappa_classificacao"),
                            row.get("intensidade_global_adc"), row.get("pico_espectral_nm"), row.get("pico_espectral_adc"),
                            row.get("razao_celulose"), row.get("razao_agua"),
                            row.get("adc_610"), row.get("adc_680"), row.get("adc_730"), row.get("adc_760"), row.get("adc_810"), row.get("adc_860"),
                            row.get("ref_610"), row.get("ref_680"), row.get("ref_730"), row.get("ref_760"), row.get("ref_810"), row.get("ref_860")
                        ])
                QMessageBox.information(self, "Exportação Concluída", f"Exportados {len(self.leituras)} registros com sucesso para:\n{file_path}")
            except Exception as e:
                QMessageBox.critical(self, "Erro", f"Erro ao exportar CSV: {e}")


# =====================================================================
# 1. INDICADOR DE STATUS / BADGE
# =====================================================================
class ModernStatusBadge(QFrame):
    def __init__(self, title="STATUS", active_color="#10B981", inactive_color="#64748B", parent=None):
        super().__init__(parent)
        self.active_color = active_color
        self.inactive_color = inactive_color
        self.is_active = False

        self.setStyleSheet("""
            QFrame {
                background-color: #202020;
                border: 1px solid #383838;
                border-radius: 6px;
            }
        """)

        layout = QHBoxLayout(self)
        layout.setContentsMargins(8, 4, 8, 4)
        layout.setSpacing(6)

        self.dot = QLabel("●")
        self.dot.setStyleSheet(f"color: {self.inactive_color}; font-size: 11px;")

        self.lbl_text = QLabel(f"{title}: DESCONECTADO")
        self.lbl_text.setStyleSheet("color: #D1D5DB; font-size: 10px; font-weight: bold; font-family: 'Segoe UI';")

        layout.addWidget(self.dot)
        layout.addWidget(self.lbl_text)
        self.title = title

    def set_active(self, active: bool, status_text: str = None, custom_color: str = None):
        self.is_active = active
        if custom_color:
            color = custom_color
        else:
            color = self.active_color if active else self.inactive_color
        self.dot.setStyleSheet(f"color: {color}; font-size: 11px;")
        if status_text:
            self.lbl_text.setText(f"{self.title}: {status_text}")
        else:
            txt = "CONECTADO" if active else "DESCONECTADO"
            self.lbl_text.setText(f"{self.title}: {txt}")
        if custom_color:
            self.lbl_text.setStyleSheet(f"color: {custom_color}; font-size: 10px; font-weight: bold; font-family: 'Segoe UI';")
        else:
            self.lbl_text.setStyleSheet("color: #D1D5DB; font-size: 10px; font-weight: bold; font-family: 'Segoe UI';")


# =====================================================================
# 2. KPI CARD ESTILO POWER BI (WINDOWS 11 FLUENT)
# =====================================================================
class PowerBiKpiCard(QFrame):
    def __init__(self, icon_str, title_str, default_value="--", subtitle_str="", accent_color="#38BDF8", parent=None):
        super().__init__(parent)
        self.accent_color = accent_color
        self.setObjectName("kpiCard")
        self.setStyleSheet(f"""
            QFrame#kpiCard {{
                background-color: #2b2b2b;
                border: 1px solid #3d3d3d;
                border-top: 1px solid #3d3d3d;
                border-radius: 8px;
            }}
        """)

        layout = QVBoxLayout(self)
        layout.setContentsMargins(14, 10, 14, 10)
        layout.setSpacing(2)

        header = QHBoxLayout()
        header.setSpacing(6)
        lbl_icon = QLabel(icon_str)
        lbl_icon.setStyleSheet("font-size: 13px;")

        self.lbl_title = QLabel(title_str)
        self.lbl_title.setStyleSheet("color: #9CA3AF; font-size: 10px; font-weight: bold; font-family: 'Segoe UI'; letter-spacing: 0.5px;")

        header.addWidget(lbl_icon)
        header.addWidget(self.lbl_title)
        header.addStretch()
        layout.addLayout(header)

        self.lbl_value = QLabel(default_value)
        self.lbl_value.setStyleSheet("color: #FFFFFF; font-size: 25px; font-weight: 600; font-family: 'Segoe UI';")
        layout.addWidget(self.lbl_value)

        self.lbl_sub = QLabel(subtitle_str)
        self.lbl_sub.setStyleSheet("color: #6B7280; font-size: 10px; font-family: 'Segoe UI';")
        self.lbl_sub.setWordWrap(True)
        layout.addWidget(self.lbl_sub)

    def set_value(self, value_text: str, subtitle_text: str = None, color_override: str = None):
        self.lbl_value.setText(value_text)
        if color_override:
            self.lbl_value.setStyleSheet(f"color: {color_override}; font-size: 25px; font-weight: 600; font-family: 'Segoe UI';")
        else:
            self.lbl_value.setStyleSheet("color: #FFFFFF; font-size: 25px; font-weight: 600; font-family: 'Segoe UI';")
        if subtitle_text is not None:
            self.lbl_sub.setText(subtitle_text)


# =====================================================================
# 2.5 CARD KPI DE MONITORAMENTO DA CALIBRAÇÃO (R², RMSE, N, BADGE)
# =====================================================================
class CardKpiCalibracao(QFrame):
    """
    Card de métricas (KPI) de monitoramento da calibração instrumental.
    Exibe:
    - Título: 'Status da Calibração'
    - R² (Coeficiente de Determinação): formatado com 3 casas decimais (ex: 0.000 ou --)
    - RMSE (Erro Médio Quadrático): formatado com 3 casas decimais (ex: ± 0.000 ou --)
    - Aquisições de branco (N): quantidade de amostras (ex: N = 0)
    - Badge de Validação Visual:
      * R² >= 0.95: 'Calibrado (Excelente)' (fundo verde suave)
      * 0.85 <= R² < 0.95: 'Calibrado (Ajuste Regular)' (fundo amarelo/laranja suave)
      * R² < 0.85 ou curva vazia: 'Não Calibrado / Baixo Ajuste' (fundo cinza/vermelho suave)
    """
    def __init__(self, parent=None):
        super().__init__(parent)
        self.setObjectName("cardKpiCalibracao")
        self.setStyleSheet("""
            QFrame#cardKpiCalibracao {
                background-color: #1A1F26;
                border: 1px solid #374151;
                border-radius: 8px;
            }
            QLabel {
                font-family: 'Segoe UI', Arial, sans-serif;
            }
        """)

        layout = QVBoxLayout(self)
        layout.setContentsMargins(12, 10, 12, 10)
        layout.setSpacing(8)

        # Cabeçalho: Título + Badge de Validação
        header = QHBoxLayout()
        icon = QLabel("📊")
        icon.setStyleSheet("font-size: 14px;")
        lbl_title = QLabel("Status da Calibração")
        lbl_title.setStyleSheet("color: #38BDF8; font-size: 11px; font-weight: bold; letter-spacing: 0.5px;")

        self.lbl_badge = QLabel("Não Calibrado / Baixo Ajuste")
        self.lbl_badge.setAlignment(Qt.AlignCenter)
        self.lbl_badge.setStyleSheet("""
            background-color: #2D1A1F;
            color: #F87171;
            border: 1px solid #DC2626;
            border-radius: 4px;
            padding: 3px 8px;
            font-size: 10px;
            font-weight: bold;
        """)

        header.addWidget(icon)
        header.addWidget(lbl_title)
        header.addStretch()
        header.addWidget(self.lbl_badge)
        layout.addLayout(header)

        # Métricas em destaque (3 colunas com cartões individuais)
        metrics_layout = QHBoxLayout()
        metrics_layout.setSpacing(8)

        # 1. R²
        box_r2 = QFrame()
        box_r2.setStyleSheet("background-color: #11141A; border: 1px solid #1F2937; border-radius: 6px;")
        l_r2 = QVBoxLayout(box_r2)
        l_r2.setContentsMargins(8, 6, 8, 6)
        l_r2.setSpacing(2)
        sub_r2 = QLabel("CV branco máximo (%)")
        sub_r2.setStyleSheet("color: #9CA3AF; font-size: 9px; font-weight: 600;")
        self.lbl_r2 = QLabel("--")
        self.lbl_r2.setStyleSheet("color: #38BDF8; font-size: 16px; font-weight: 800;")
        l_r2.addWidget(sub_r2)
        l_r2.addWidget(self.lbl_r2)
        metrics_layout.addWidget(box_r2)

        # 2. RMSE
        box_rmse = QFrame()
        box_rmse.setStyleSheet("background-color: #11141A; border: 1px solid #1F2937; border-radius: 6px;")
        l_rmse = QVBoxLayout(box_rmse)
        l_rmse.setContentsMargins(8, 6, 8, 6)
        l_rmse.setSpacing(2)
        sub_rmse = QLabel("Ruído escuro máximo (ADC)")
        sub_rmse.setStyleSheet("color: #9CA3AF; font-size: 9px; font-weight: 600;")
        self.lbl_rmse = QLabel("--")
        self.lbl_rmse.setStyleSheet("color: #A78BFA; font-size: 16px; font-weight: 800;")
        l_rmse.addWidget(sub_rmse)
        l_rmse.addWidget(self.lbl_rmse)
        metrics_layout.addWidget(box_rmse)

        # 3. Pontos (N)
        box_n = QFrame()
        box_n.setStyleSheet("background-color: #11141A; border: 1px solid #1F2937; border-radius: 6px;")
        l_n = QVBoxLayout(box_n)
        l_n.setContentsMargins(8, 6, 8, 6)
        l_n.setSpacing(2)
        sub_n = QLabel("Pontos (N)")
        sub_n.setStyleSheet("color: #9CA3AF; font-size: 9px; font-weight: 600;")
        self.lbl_n = QLabel("N = 0")
        self.lbl_n.setStyleSheet("color: #FBBF24; font-size: 16px; font-weight: 800;")
        l_n.addWidget(sub_n)
        l_n.addWidget(self.lbl_n)
        metrics_layout.addWidget(box_n)

        layout.addLayout(metrics_layout)

        # Rodapé com metadados de calibração (Data/Hora e Operador)
        self.lbl_calib_footer = QLabel("🕒 Calibração: --")
        self.lbl_calib_footer.setStyleSheet("color: #9CA3AF; font-size: 10px;")
        layout.addWidget(self.lbl_calib_footer)

    def atualizar(self,r2=None,rmse=None,n_amostras=0,timestamp=None,operador=None,is_expired=False):
        win=self.window()
        if not hasattr(win,"chem_engine"):
            win=getattr(win,"main_win",None)
        eng=getattr(win,"chem_engine",None)
        p=eng.snapshot() if eng else {}
        ws,ds=p.get("white_stats",{}),p.get("dark_stats",{})
        self.lbl_r2.setText(f"{max(ws['cv_percent']):.2f}" if ws.get("cv_percent") else "--")
        self.lbl_rmse.setText(f"{max(ds['stdevs']):.2f}" if ds.get("stdevs") else "--")
        self.lbl_n.setText(f"N = {ws.get('n',0)}")
        self.lbl_calib_footer.setText(f"{timestamp or '--'} | Op: {operador or '--'}")
        valid=bool(eng and eng.calibration_valid())
        self.lbl_badge.setText("REFERÊNCIA VÁLIDA" if valid else "RECALIBRAR")
        self.lbl_badge.setStyleSheet("color: #34D399;" if valid else "color: #F87171;")


# =====================================================================
# 2.6 CARD DE DIAGNÓSTICO & TELEMETRIA DO SENSOR AS7263
# =====================================================================
from diagnostics import SensorDiagnosticsCard as CardDiagnosticoAS7263


# =====================================================================
# 3. DIÁLOGO MODAL DE CALIBRAÇÃO INSTRUMENTAL (BRANCO & ESCURO)
# =====================================================================
class CalibrationModalDialog(QDialog):
    """
    Diálogo para medição de Branco (Lâmina + Lamínula com Água Destilada) e Escuro Instrumental.
    """
    def __init__(self, main_win, parent=None):
        super().__init__(parent or main_win)
        self.main_win = main_win
        self.setWindowTitle("Referenciamento óptico — branco e escuro")
        self.setFixedSize(540, 520)
        self.setStyleSheet("""
            QDialog {
                background-color: #202020;
                color: #FFFFFF;
                border: 1px solid #3d3d3d;
                border-radius: 10px;
            }
            QLabel {
                color: #E5E7EB;
                font-family: 'Segoe UI';
            }
            QPushButton {
                background-color: #333333;
                color: #FFFFFF;
                border: 1px solid #4a4a4a;
                border-radius: 6px;
                padding: 10px 14px;
                font-weight: bold;
                font-size: 11px;
            }
            QPushButton:hover {
                background-color: #0284C7;
                border-color: #38BDF8;
            }
            QPushButton#btnPrimary {
                background-color: #0284C7;
                color: #FFFFFF;
                border: none;
            }
            QPushButton#btnPrimary:hover {
                background-color: #0369A1;
            }
        """)

        layout = QVBoxLayout(self)
        layout.setContentsMargins(20, 20, 20, 20)
        layout.setSpacing(12)

        title = QLabel("🎯 CALIBRAÇÃO INSTRUMENTAL DE REFERÊNCIA")
        title.setStyleSheet("color: #38BDF8; font-size: 13px; font-weight: bold; letter-spacing: 0.5px;")
        layout.addWidget(title)

        info_box = QFrame()
        info_box.setStyleSheet("background-color: #262626; border: 1px solid #383838; border-radius: 8px;")
        ib_layout = QVBoxLayout(info_box)
        ib_layout.setContentsMargins(12, 10, 12, 10)

        eng = self.main_win.chem_engine
        if eng.active_mode == "seco":
            desc_text = (
                "<b>Metodologia de Amostras Secas (Reflectância Difusa):</b><br>"
                "1. <b>Branco de Referência:</b> Insira na gaveta o <b>cartão branco fosco de referência</b> "
                "(cartão branco fosco), sem lâmina de vidro e sem solvente líquido.<br>"
                "2. <b>Escuro Instrumental:</b> Mede dez aquisições com LED desligado e câmara fechada."
            )
        else:
            desc_text = (
                "<b>Metodologia Quimiométrica de Celulose (Suspensão Aquosa):</b><br>"
                "1. <b>Branco de Referência:</b> Insira na gaveta uma lâmina e lamínula contendo "
                "apenas <b>água destilada pura</b> (matriz do solvente).<br>"
                "2. <b>Escuro Instrumental:</b> Mede o ruído elétrico/corrente de escuro do sensor."
            )

        lbl_desc = QLabel(desc_text)
        lbl_desc.setStyleSheet("color: #D1D5DB; font-size: 11px; line-height: 1.4;")
        lbl_desc.setWordWrap(True)
        ib_layout.addWidget(lbl_desc)
        layout.addWidget(info_box)

        # Configuração do Intervalo de Prazo operacional
        timeout_frame = QFrame()
        timeout_frame.setStyleSheet("background-color: #1F2937; border: 1px solid #374151; border-radius: 6px;")
        timeout_layout = QHBoxLayout(timeout_frame)
        timeout_layout.setContentsMargins(10, 6, 10, 6)
        timeout_layout.setSpacing(8)

        lbl_to = QLabel("⏱️ Prazo operacional da Calibração:")
        lbl_to.setStyleSheet("color: #D1D5DB; font-size: 11px; font-weight: bold;")
        self.combo_calib_timeout = QComboBox()
        for text, secs in CALIB_TIMEOUT_OPTIONS:
            self.combo_calib_timeout.addItem(text, secs)

        cur_to = self.main_win.chem_engine.timeout_segundos
        cur_idx = 4
        for i in range(self.combo_calib_timeout.count()):
            if self.combo_calib_timeout.itemData(i) == cur_to:
                cur_idx = i
                break
        self.combo_calib_timeout.setCurrentIndex(cur_idx)
        self.combo_calib_timeout.setStyleSheet("""
            QComboBox {
                background-color: #111827;
                color: #FFFFFF;
                border: 1px solid #4B5563;
                border-radius: 4px;
                padding: 4px 8px;
                font-size: 11px;
            }
        """)
        self.combo_calib_timeout.currentIndexChanged.connect(self._on_timeout_changed)

        timeout_layout.addWidget(lbl_to)
        timeout_layout.addWidget(self.combo_calib_timeout)
        layout.addWidget(timeout_frame)

        # Card KPI de Monitoramento da Calibração
        self.card_kpi = CardKpiCalibracao(self)
        layout.addWidget(self.card_kpi)

        # Status Atual
        eng = self.main_win.chem_engine
        is_exp = eng.is_calibration_expired()
        if eng.is_calibrated:
            self.card_kpi.atualizar(
                r2=eng.r2, rmse=eng.rmse, n_amostras=eng.n_amostras,
                timestamp=eng.calib_timestamp, operador=eng.calib_operador,
                is_expired=is_exp
            )
        else:
            self.card_kpi.atualizar(r2=None, rmse=None, n_amostras=0, is_expired=True)

        if not eng.is_calibrated:
            st_text = "Status Atual: NÃO CALIBRADO"
            st_color = "#EF4444"
        elif is_exp:
            st_text = f"Status Atual: CALIBRAÇÃO EXPIRADA ({eng.calib_timestamp})"
            st_color = "#EF4444"
        else:
            st_text = f"Status Atual: CALIBRADO E VÁLIDO ({eng.calib_timestamp})"
            st_color = "#10B981"

        self.lbl_calib_info = QLabel(st_text)
        self.lbl_calib_info.setStyleSheet(f"color: {st_color}; font-size: 11px; font-weight: bold;")
        layout.addWidget(self.lbl_calib_info)

        # Botão 1: Calibração Sequencial Guiada
        self.btn_read_white = QPushButton("🎯 Iniciar Calibração Sequencial Completa (Branco -> Escuro)")
        self.btn_read_white.setObjectName("btnPrimary")
        self.btn_read_white.clicked.connect(self.trigger_white_calibration)
        layout.addWidget(self.btn_read_white)

        # Botão 2: Medir Escuro
        self.btn_read_dark = QPushButton("🌑 2. Definir Corrente de Escuro Manual (Zero Físico)")
        self.btn_read_dark.clicked.connect(self.set_dark_current_zeros)
        self.btn_read_dark.setEnabled(False)
        self.btn_read_dark.setText("Escuro medido automaticamente com LED desligado")
        layout.addWidget(self.btn_read_dark)

        layout.addStretch()

        # Botão Fechar
        btn_close = QPushButton("Fechar")
        btn_close.clicked.connect(self.accept)
        layout.addWidget(btn_close)

    def _on_timeout_changed(self, idx: int):
        secs = self.combo_calib_timeout.currentData()
        if secs:
            self.main_win.chem_engine.set_timeout_seconds(secs)
            self.main_win._check_calibration_validity()

    def trigger_white_calibration(self):
        if not self.main_win.is_serial_connected():
            QMessageBox.warning(self, "Hardware Desconectado", "Conecte o hardware ESP32 antes de calibrar.")
            return

        self.accept()
        self.main_win.start_white_calibration_cycle()

    def set_dark_current_zeros(self):
        self.lbl_calib_info.setText("Zero nominal desativado. Execute a calibração completa.")


# =====================================================================
# 4. DIÁLOGO MODAL DE INTERTRAVAMENTO HUMANO (CARREGAMENTO DE LÂMINA)
# =====================================================================
class SamplePlacementInterlockDialog(QDialog):
    """
    Janela modal de intertravamento humano para confirmação de posicionamento da lâmina.
    Exibida exclusivamente após a confirmação de hardware STATUS:GAVETA_ABERTA.
    """
    def __init__(self, title="Posicionamento de Amostra", message=None, parent=None):
        super().__init__(parent)
        self.setWindowTitle(title)
        self.setFixedSize(510, 270)
        self.setModal(True)
        self.setWindowFlags(self.windowFlags() & ~Qt.WindowContextHelpButtonHint)
        self.setStyleSheet("""
            QDialog {
                background-color: #202020;
                color: #FFFFFF;
                border: 1px solid #3d3d3d;
                border-radius: 10px;
            }
            QLabel {
                color: #FFFFFF;
                font-family: 'Segoe UI';
            }
            QPushButton {
                background-color: #333333;
                color: #FFFFFF;
                border: 1px solid #4a4a4a;
                border-radius: 6px;
                padding: 10px 18px;
                font-weight: bold;
                font-size: 11px;
            }
            QPushButton#btnConfirm {
                background-color: #0284C7;
                color: #FFFFFF;
                border: 1px solid #38BDF8;
            }
            QPushButton#btnConfirm:hover {
                background-color: #0369A1;
            }
            QPushButton#btnCancel {
                background-color: #2E1519;
                color: #F87171;
                border: 1px solid #DC2626;
            }
            QPushButton#btnCancel:hover {
                background-color: #7F1D1D;
                color: #FFFFFF;
            }
        """)

        layout = QVBoxLayout(self)
        layout.setContentsMargins(22, 20, 22, 20)
        layout.setSpacing(14)

        # Header com ícone
        header = QHBoxLayout()
        icon = QLabel("📦")
        icon.setStyleSheet("font-size: 24px;")
        lbl_title = QLabel(f"<b>{title.upper()}</b>")
        lbl_title.setStyleSheet("color: #38BDF8; font-size: 13px; letter-spacing: 0.5px;")
        header.addWidget(icon)
        header.addWidget(lbl_title)
        header.addStretch()
        layout.addLayout(header)

        # Mensagem informativa
        default_msg = (
            "A gaveta está aberta.<br><br>"
            "Insira a <b>lâmina com a lamínula</b> sobre o berço óptico de leitura e "
            "clique em <b>OK / Iniciar</b> para prosseguir com a medição."
        )
        self.lbl_msg = QLabel(message or default_msg)
        self.lbl_msg.setStyleSheet("color: #D1D5DB; font-size: 11px; line-height: 1.5;")
        self.lbl_msg.setWordWrap(True)
        layout.addWidget(self.lbl_msg)

        layout.addStretch()

        # Botões de Ação [ Cancelar / Abortar ] e [ OK / Iniciar ]
        btn_layout = QHBoxLayout()
        btn_layout.setSpacing(12)

        self.btn_cancel = QPushButton("❌ Cancelar / Abortar")
        self.btn_cancel.setObjectName("btnCancel")
        self.btn_cancel.setCursor(Qt.PointingHandCursor)
        self.btn_cancel.clicked.connect(self.reject)

        self.btn_confirm = QPushButton("✔ OK / Iniciar")
        self.btn_confirm.setObjectName("btnConfirm")
        self.btn_confirm.setCursor(Qt.PointingHandCursor)
        self.btn_confirm.clicked.connect(self.accept)

        btn_layout.addStretch()
        btn_layout.addWidget(self.btn_cancel)
        btn_layout.addWidget(self.btn_confirm)
        layout.addLayout(btn_layout)



# =====================================================================
# 5. DIÁLOGOS DE TRANSIÇÃO E SEGURANÇA DA CALIBRAÇÃO (ETAPA 2)
# =====================================================================
class CalibrationTransitionDialog(QDialog):
    """
    Popup 2: Transição entre Calibração de Branco e Fundo Escuro.
    Exibido com a gaveta aberta após a leitura do branco.
    """
    def __init__(self, parent=None):
        super().__init__(parent)
        self.setWindowTitle("Calibração de Branco Concluída")
        self.setFixedSize(510, 270)
        self.setModal(True)
        self.setWindowFlags(self.windowFlags() & ~Qt.WindowContextHelpButtonHint)
        self.setStyleSheet("""
            QDialog {
                background-color: #202020;
                color: #FFFFFF;
                border: 1px solid #3d3d3d;
                border-radius: 10px;
            }
            QLabel {
                color: #FFFFFF;
                font-family: 'Segoe UI';
            }
            QPushButton {
                background-color: #333333;
                color: #FFFFFF;
                border: 1px solid #4a4a4a;
                border-radius: 6px;
                padding: 10px 18px;
                font-weight: bold;
                font-size: 11px;
            }
            QPushButton#btnProceed {
                background-color: #0284C7;
                color: #FFFFFF;
                border: 1px solid #38BDF8;
            }
            QPushButton#btnProceed:hover {
                background-color: #0369A1;
            }
            QPushButton#btnClose {
                background-color: #2b2b2b;
                color: #E5E7EB;
                border: 1px solid #4a4a4a;
            }
            QPushButton#btnClose:hover {
                background-color: #383838;
                border-color: #6B7280;
            }
        """)

        layout = QVBoxLayout(self)
        layout.setContentsMargins(22, 20, 22, 20)
        layout.setSpacing(14)

        header = QHBoxLayout()
        icon = QLabel("💧")
        icon.setStyleSheet("font-size: 24px;")
        lbl_title = QLabel("<b>BRANCO MEDIDO — FALTA MEDIR O ESCURO</b>")
        lbl_title.setStyleSheet("color: #38BDF8; font-size: 13px; letter-spacing: 0.5px;")
        header.addWidget(icon)
        header.addWidget(lbl_title)
        header.addStretch()
        layout.addLayout(header)

        is_dry = (self.parent() and hasattr(self.parent(), "chem_engine") and self.parent().chem_engine.active_mode == "seco")
        ref_text = "cartão branco fosco de referência" if is_dry else "referência em água destilada"
        msg = (
            f"Leitura de {ref_text} registrada com sucesso.<br><br>"
            "Deseja prosseguir para a <b>Calibração de Fundo Escuro</b> agora?<br>"
            "<small style='color: #9CA3AF;'>Se cancelar, a gaveta será fechada e esta calibração incompleta será descartada.</small>"
        )
        self.lbl_msg = QLabel(msg)
        self.lbl_msg.setStyleSheet("color: #D1D5DB; font-size: 11px; line-height: 1.5;")
        self.lbl_msg.setWordWrap(True)
        layout.addWidget(self.lbl_msg)

        layout.addStretch()

        btn_layout = QHBoxLayout()
        btn_layout.setSpacing(12)

        self.btn_exit = QPushButton("🚪 Cancelar / Sair")
        self.btn_exit.setObjectName("btnClose")
        self.btn_exit.setCursor(Qt.PointingHandCursor)
        self.btn_exit.clicked.connect(self.reject)

        self.btn_proceed = QPushButton("🚀 Prosseguir para Escuro")
        self.btn_proceed.setObjectName("btnProceed")
        self.btn_proceed.setCursor(Qt.PointingHandCursor)
        self.btn_proceed.clicked.connect(self.accept)

        btn_layout.addStretch()
        btn_layout.addWidget(self.btn_exit)
        btn_layout.addWidget(self.btn_proceed)
        layout.addLayout(btn_layout)


class DarkSafetyInterlockDialog(QDialog):
    """
    Popup 3: Confirmação de Retirada da Lâmina e Gaveta Vazia para Fundo Escuro.
    """
    def __init__(self, parent=None):
        super().__init__(parent)
        self.setWindowTitle("Aviso de Segurança — Fundo Escuro")
        self.setFixedSize(520, 270)
        self.setModal(True)
        self.setWindowFlags(self.windowFlags() & ~Qt.WindowContextHelpButtonHint)
        self.setStyleSheet("""
            QDialog {
                background-color: #202020;
                color: #FFFFFF;
                border: 1px solid #3d3d3d;
                border-radius: 10px;
            }
            QLabel {
                color: #FFFFFF;
                font-family: 'Segoe UI';
            }
            QPushButton {
                background-color: #333333;
                color: #FFFFFF;
                border: 1px solid #4a4a4a;
                border-radius: 6px;
                padding: 10px 18px;
                font-weight: bold;
                font-size: 11px;
            }
            QPushButton#btnConfirmEmpty {
                background-color: #15803D;
                color: #FFFFFF;
                border: 1px solid #22C55E;
            }
            QPushButton#btnConfirmEmpty:hover {
                background-color: #166534;
            }
            QPushButton#btnCancel {
                background-color: #2E1519;
                color: #F87171;
                border: 1px solid #DC2626;
            }
            QPushButton#btnCancel:hover {
                background-color: #7F1D1D;
                color: #FFFFFF;
            }
        """)

        layout = QVBoxLayout(self)
        layout.setContentsMargins(22, 20, 22, 20)
        layout.setSpacing(14)

        header = QHBoxLayout()
        icon = QLabel("⚠️")
        icon.setStyleSheet("font-size: 24px;")
        lbl_title = QLabel("<b>AVISO DE SEGURANÇA — FUNDO ESCURO</b>")
        lbl_title.setStyleSheet("color: #F59E0B; font-size: 13px; letter-spacing: 0.5px;")
        header.addWidget(icon)
        header.addWidget(lbl_title)
        header.addStretch()
        layout.addLayout(header)

        msg = (
            "<b>Atenção:</b> A calibração de fundo escuro deve ser realizada com o <b>BERÇO TOTALMENTE VAZIO</b>.<br><br>"
            "Você já retirou a lâmina de água da gaveta?"
        )
        self.lbl_msg = QLabel(msg)
        self.lbl_msg.setStyleSheet("color: #E5E7EB; font-size: 11px; line-height: 1.5;")
        self.lbl_msg.setWordWrap(True)
        layout.addWidget(self.lbl_msg)

        layout.addStretch()

        btn_layout = QHBoxLayout()
        btn_layout.setSpacing(12)

        self.btn_cancel = QPushButton("❌ Cancelar / Sair")
        self.btn_cancel.setObjectName("btnCancel")
        self.btn_cancel.setCursor(Qt.PointingHandCursor)
        self.btn_cancel.clicked.connect(self.reject)

        self.btn_confirm = QPushButton("✔ Sim, lâmina removida e gaveta vazia")
        self.btn_confirm.setObjectName("btnConfirmEmpty")
        self.btn_confirm.setCursor(Qt.PointingHandCursor)
        self.btn_confirm.clicked.connect(self.accept)

        btn_layout.addStretch()
        btn_layout.addWidget(self.btn_cancel)
        btn_layout.addWidget(self.btn_confirm)
        layout.addLayout(btn_layout)


# =====================================================================
# 5.1 DIÁLOGO MODAL DE DECISÃO OPERACIONAL (FIM DE ENSAIO)
# =====================================================================
class DialogDecisaoConclusao(QDialog):
    """
    Diálogo modal com 3 botões claros de decisão ao concluir a leitura com a gaveta aberta:
    1. [ Finalizar e Fechar Gaveta ] (Padrão/Foco)
    2. [ Nova Análise ] (Mantém gaveta aberta, limpa dados e solicita novo ID)
    3. [ Iniciar Repetibilidade ] (Mantém gaveta aberta para inspeção e inicia repetições)
    """
    ACTION_FINISH = 1
    ACTION_NEW_SCAN = 2
    ACTION_REPEAT = 3

    def __init__(self, parent=None, is_repeatability=False):
        super().__init__(parent)
        self.setWindowTitle("Ensaio Concluído — Decisão Operacional")
        self.setFixedSize(540, 290)
        self.setModal(True)
        self.setWindowFlags(self.windowFlags() & ~Qt.WindowContextHelpButtonHint)
        self.selected_action = self.ACTION_FINISH

        self.setStyleSheet("""
            QDialog {
                background-color: #1F242D;
                color: #FFFFFF;
                border: 1px solid #374151;
                border-radius: 12px;
            }
            QLabel {
                color: #FFFFFF;
                font-family: 'Segoe UI', sans-serif;
            }
            QPushButton {
                border-radius: 6px;
                padding: 10px 16px;
                font-weight: bold;
                font-size: 11px;
                min-height: 20px;
            }
            QPushButton#btnFinish {
                background-color: #1E293B;
                color: #38BDF8;
                border: 1px solid #0284C7;
            }
            QPushButton#btnFinish:hover {
                background-color: #0369A1;
                color: #FFFFFF;
            }
            QPushButton#btnNewScan {
                background-color: #0284C7;
                color: #FFFFFF;
                border: 1px solid #38BDF8;
            }
            QPushButton#btnNewScan:hover {
                background-color: #0369A1;
            }
            QPushButton#btnRepeat {
                background-color: #4C1D95;
                color: #DDD6FE;
                border: 1px solid #8B5CF6;
            }
            QPushButton#btnRepeat:hover {
                background-color: #5B21B6;
                color: #FFFFFF;
            }
        """)

        layout = QVBoxLayout(self)
        layout.setContentsMargins(22, 20, 22, 20)
        layout.setSpacing(14)

        # Header
        header = QHBoxLayout()
        icon = QLabel("✔" if not is_repeatability else "📊")
        icon.setStyleSheet("font-size: 24px; color: #10B981;")
        lbl_h = QLabel("<b>LEITURA CONCLUÍDA COM SUCESSO</b>" if not is_repeatability else "<b>ENSAIO DE REPETIBILIDADE CONCLUÍDO</b>")
        lbl_h.setStyleSheet("color: #10B981; font-size: 12px; font-weight: bold; letter-spacing: 0.5px;")
        header.addWidget(icon)
        header.addWidget(lbl_h)
        header.addStretch()
        layout.addLayout(header)

        lbl_desc = QLabel(
            "A leitura óptica foi concluída e a gaveta está <b>aberta</b> no berço para manipulação da lâmina.<br>"
            "Selecione a ação desejada a seguir:"
        )
        lbl_desc.setStyleSheet("color: #D1D5DB; font-size: 11px; line-height: 1.5;")
        lbl_desc.setWordWrap(True)
        layout.addWidget(lbl_desc)

        layout.addStretch()

        btn_box = QVBoxLayout()
        btn_box.setSpacing(8)

        # Botão 1: Padrão / Foco
        self.btn_finish = QPushButton("📥 Finalizar e Fechar Gaveta (Padrão)")
        self.btn_finish.setObjectName("btnFinish")
        self.btn_finish.setCursor(Qt.PointingHandCursor)
        self.btn_finish.setDefault(True)
        self.btn_finish.setFocus()
        self.btn_finish.clicked.connect(self._choose_finish)

        # Botão 2: Nova Análise
        self.btn_new = QPushButton("🔬 Nova Análise (Manter Gaveta Aberta)")
        self.btn_new.setObjectName("btnNewScan")
        self.btn_new.setCursor(Qt.PointingHandCursor)
        self.btn_new.clicked.connect(self._choose_new)

        # Botão 3: Iniciar Repetibilidade
        self.btn_repeat = QPushButton("🔁 Iniciar Repetibilidade (5 Leituras Consecutivas)")
        self.btn_repeat.setObjectName("btnRepeat")
        self.btn_repeat.setCursor(Qt.PointingHandCursor)
        self.btn_repeat.clicked.connect(self._choose_repeat)

        btn_box.addWidget(self.btn_finish)
        btn_box.addWidget(self.btn_new)
        btn_box.addWidget(self.btn_repeat)
        layout.addLayout(btn_box)

    def _choose_finish(self):
        self.selected_action = self.ACTION_FINISH
        self.accept()

    def _choose_new(self):
        self.selected_action = self.ACTION_NEW_SCAN
        self.accept()

    def _choose_repeat(self):
        self.selected_action = self.ACTION_REPEAT
        self.accept()


# =====================================================================
# 6. POPUP DE SEGURANÇA CONTRA RADIAÇÃO ÓPTICA (NIR) - ASSÍNCRONO
# =====================================================================
class DialogAlertaRadiacao(OperatingAlertDialog):
    """
    Diálogo modal não-bloqueante de aviso de segurança contra radiação óptica NIR.
    Abre automaticamente via .show() ao avançar o sensor para varredura óptica e fecha via .close().
    Possui botão de parada de emergência acessível diretamente durante a operação.
    """
    def __init__(self, parent=None):
        super().__init__(parent)
        self.setWindowTitle("⚠️ AVISO DE SEGURANÇA: EMISSÃO ÓPTICA ATIVA")
        self.setFixedSize(530, 315)
        self.setWindowModality(Qt.ApplicationModal)
        # Desabilita botão 'X' de fechar a janela e botão de Ajuda
        self.setWindowFlags((self.windowFlags() | Qt.Dialog) & ~Qt.WindowCloseButtonHint & ~Qt.WindowContextHelpButtonHint)

        self.setStyleSheet("""
            QDialog {
                background-color: #1a1712;
                color: #FFFFFF;
                border: 2px solid #F59E0B;
                border-radius: 10px;
            }
            QLabel {
                color: #FFFFFF;
                font-family: 'Segoe UI', Arial, sans-serif;
            }
            QProgressBar {
                background-color: #2b2518;
                border: 1px solid #78350F;
                border-radius: 5px;
                height: 12px;
                text-align: center;
            }
            QProgressBar::chunk {
                background-color: #F59E0B;
                border-radius: 4px;
            }
        """)

        layout = QVBoxLayout(self)
        layout.setContentsMargins(24, 20, 24, 20)
        layout.setSpacing(12)

        # Cabeçalho com ícone de advertência
        header = QHBoxLayout()
        lbl_icon = WarningSymbol()

        title_box = QVBoxLayout()
        title_box.setSpacing(2)
        lbl_t1 = QLabel("AVISO DE SEGURANÇA — RADIAÇÃO ÓPTICA")
        lbl_t1.setStyleSheet("color: #F59E0B; font-size: 11px; font-weight: bold; letter-spacing: 0.8px;")
        lbl_t2 = QLabel("EMISSOR NIR ATIVO (730 nm - 860 nm)")
        lbl_t2.setStyleSheet("color: #FDE68A; font-size: 15px; font-weight: bold;")
        title_box.addWidget(lbl_t1)
        title_box.addWidget(lbl_t2)

        header.addWidget(lbl_icon)
        header.addLayout(title_box)
        header.addStretch()
        layout.addLayout(header)

        # Caixa de alerta e orientações
        msg_frame = QFrame()
        msg_frame.setStyleSheet("background-color: #291F11; border: 1px solid #78350F; border-radius: 6px; padding: 6px;")
        mf_layout = QVBoxLayout(msg_frame)
        mf_layout.setContentsMargins(12, 8, 12, 8)
        lbl_sub = QLabel(
            "Não olhe diretamente para a abertura óptica nem abra a câmara durante a varredura espectral.<br>"
            "<b>Radiação invisível de alta densidade no espectro infravermelho próximo.</b>"
        )
        lbl_sub.setStyleSheet("color: #FEF3C7; font-size: 11px; line-height: 1.4;")
        lbl_sub.setWordWrap(True)
        mf_layout.addWidget(lbl_sub)
        layout.addWidget(msg_frame)

        # Barra contínua / indeterminada (setRange(0, 0))
        self.pbar = AnimatedOperationBar()
        self.pbar.setRange(0, 0)
        layout.addWidget(self.pbar)

        self.lbl_status = QLabel("⏳ Varredura óptica em andamento. Câmara intertravada...")
        self.lbl_status.setStyleSheet("color: #D97706; font-size: 11px; font-weight: bold;")
        self.lbl_status.setAlignment(Qt.AlignCenter)
        layout.addWidget(self.lbl_status)

        # Botão de Parada de Emergência no corpo do diálogo
        self.btn_emergency = QPushButton("🛑 PARADA DE EMERGÊNCIA")
        self.btn_emergency.setCursor(Qt.PointingHandCursor)
        self.btn_emergency.setStyleSheet("""
            QPushButton {
                background-color: #d32f2f;
                color: white;
                font-weight: bold;
                font-size: 11px;
                padding: 8px 16px;
                border-radius: 4px;
                border: 1px solid #ef5350;
            }
            QPushButton:hover {
                background-color: #b71c1c;
            }
            QPushButton:pressed {
                background-color: #7f1d1d;
            }
        """)
        self.btn_emergency.clicked.connect(self._trigger_emergency)
        layout.addWidget(self.btn_emergency)

    def set_custom_status(self, text: str):
        self.lbl_status.setText(text)

    def _trigger_emergency(self):
        """
        Interrompe imediatamente as rotinas e timers em execução no Python,
        despacha CMD:EMERGENCIA\n pelo canal ativo e fecha o diálogo.
        """
        self.reject() if hasattr(self, "reject") else self.close()
        parent = self.parent()
        if parent and hasattr(parent, "stop_cycle_action"):
            parent.stop_cycle_action()
        QApplication.processEvents()


# =====================================================================
# 7. POPUP DE SEGURANÇA MECÂNICA (GAVETA MOTORIZADA) - ASSÍNCRONO
# =====================================================================
class DialogAlertaGaveta(OperatingAlertDialog):
    """
    Diálogo modal não-bloqueante de aviso de segurança contra risco de pinçamento mecânico.
    Abre automaticamente via .show() ao movimentar a gaveta em ciclos automáticos e fecha via .close().
    Possui bypass em acionamentos manuais e botão de parada de emergência acessível diretamente.
    """
    def __init__(self, parent=None):
        super().__init__(parent)
        self.setWindowTitle("⚠️ AVISO: ATUADOR MECÂNICO EM OPERAÇÃO")
        self.setFixedSize(530, 315)
        self.setWindowModality(Qt.ApplicationModal)
        # Desabilita botão 'X' de fechar a janela e botão de Ajuda
        self.setWindowFlags((self.windowFlags() | Qt.Dialog) & ~Qt.WindowCloseButtonHint & ~Qt.WindowContextHelpButtonHint)

        self.setStyleSheet("""
            QDialog {
                background-color: #1a1712;
                color: #FFFFFF;
                border: 2px solid #E67E22;
                border-radius: 10px;
            }
            QLabel {
                color: #FFFFFF;
                font-family: 'Segoe UI', Arial, sans-serif;
            }
            QProgressBar {
                background-color: #2b2518;
                border: 1px solid #78350F;
                border-radius: 5px;
                height: 12px;
                text-align: center;
            }
            QProgressBar::chunk {
                background-color: #E67E22;
                border-radius: 4px;
            }
        """)

        layout = QVBoxLayout(self)
        layout.setContentsMargins(24, 20, 24, 20)
        layout.setSpacing(12)

        # Cabeçalho com ícone de advertência mecânica
        header = QHBoxLayout()
        lbl_icon = WarningSymbol()

        title_box = QVBoxLayout()
        title_box.setSpacing(2)
        lbl_t1 = QLabel("AVISO DE SEGURANÇA — ATUADOR MECÂNICO")
        lbl_t1.setStyleSheet("color: #E67E22; font-size: 11px; font-weight: bold; letter-spacing: 0.8px;")
        self.lbl_t2 = QLabel("MOVIMENTAÇÃO DE GAVETA EM ANDAMENTO")
        self.lbl_t2.setStyleSheet("color: #FDE68A; font-size: 14px; font-weight: bold;")
        title_box.addWidget(lbl_t1)
        title_box.addWidget(self.lbl_t2)

        header.addWidget(lbl_icon)
        header.addLayout(title_box)
        header.addStretch()
        layout.addLayout(header)

        # Caixa de alerta e orientações
        msg_frame = QFrame()
        msg_frame.setStyleSheet("background-color: #291F11; border: 1px solid #78350F; border-radius: 6px; padding: 6px;")
        mf_layout = QVBoxLayout(msg_frame)
        mf_layout.setContentsMargins(12, 8, 12, 8)
        lbl_sub = QLabel(
            "<b>Mantenha mãos e objetos afastados da zona de deslocamento do berço.</b><br>"
            "Risco de pinçamento mecânico durante a movimentação motorizada da gaveta."
        )
        lbl_sub.setStyleSheet("color: #FEF3C7; font-size: 11px; line-height: 1.4;")
        lbl_sub.setWordWrap(True)
        mf_layout.addWidget(lbl_sub)
        layout.addWidget(msg_frame)

        # Barra contínua / indeterminada (setRange(0, 0))
        self.pbar = AnimatedOperationBar()
        self.pbar.setRange(0, 0)
        layout.addWidget(self.pbar)

        self.lbl_status = QLabel("⏳ Gaveta motorizada em deslocamento...")
        self.lbl_status.setStyleSheet("color: #D97706; font-size: 11px; font-weight: bold;")
        self.lbl_status.setAlignment(Qt.AlignCenter)
        layout.addWidget(self.lbl_status)

        # Botão de Parada de Emergência no corpo do diálogo
        self.btn_emergency = QPushButton("🛑 PARADA DE EMERGÊNCIA")
        self.btn_emergency.setCursor(Qt.PointingHandCursor)
        self.btn_emergency.setStyleSheet("""
            QPushButton {
                background-color: #d32f2f;
                color: white;
                font-weight: bold;
                font-size: 11px;
                padding: 8px 16px;
                border-radius: 4px;
                border: 1px solid #ef5350;
            }
            QPushButton:hover {
                background-color: #b71c1c;
            }
            QPushButton:pressed {
                background-color: #7f1d1d;
            }
        """)
        self.btn_emergency.clicked.connect(self._trigger_emergency)
        layout.addWidget(self.btn_emergency)

    def set_action_status(self, text_status: str, detail: str = "MOVIMENTAÇÃO DE GAVETA EM ANDAMENTO"):
        self.lbl_t2.setText(detail)
        self.lbl_status.setText(text_status)

    def _trigger_emergency(self):
        """
        Interrompe imediatamente as rotinas e timers em execução no Python,
        despacha CMD:EMERGENCIA\n pelo canal ativo e fecha o diálogo.
        """
        self.reject() if hasattr(self, "reject") else self.close()
        parent = self.parent()
        if parent and hasattr(parent, "stop_cycle_action"):
            parent.stop_cycle_action()
        QApplication.processEvents()
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
