yosemate/SpectrumLabPro-NIR-Kappa/supervisorio/version.py

"""
Módulo Centralizado de Versionamento Semântico
SPECTRUM-LAB PRO (Fluent Edition)
"""

__version__ = "4.17.6"
__build__ = "1274"
__release_date__ = "29/10/2026"
__app_name__ = "SPECTRUM-LAB PRO"
__app_title__ = f"{__app_name__} v{__version__} (Build {__build__})"
__app_full_title__ = f"{__app_name__} v{__version__} (Build {__build__}) | Sistema Supervisório Espectrométrico NIR (GY-AS7263)"
